TyapkinVI-VI-VI/PSFU-ATmega64/proteus/Безымянный.png

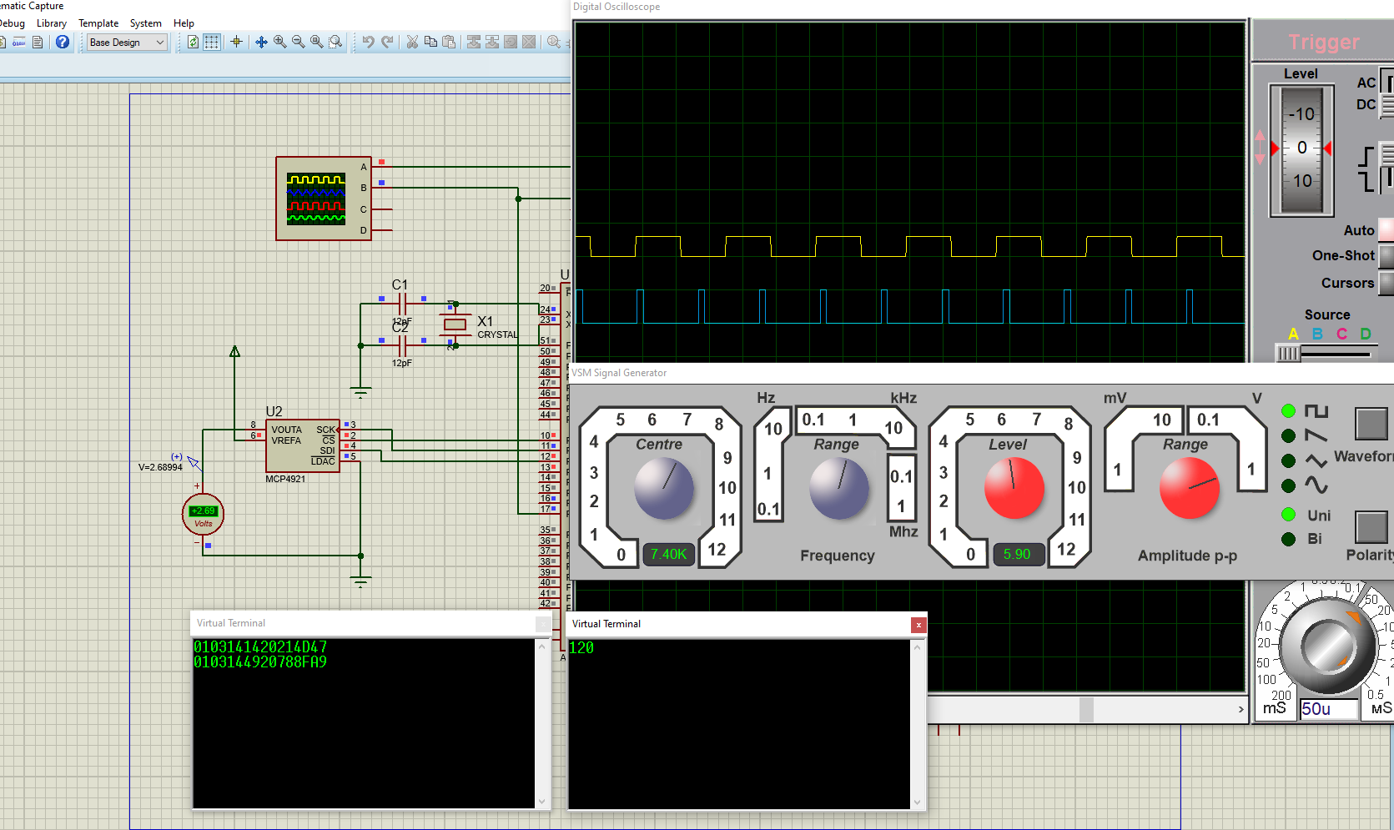
proteus/Безымянный.png
