TyapkinVI-VI-VI/PSFU-ATmega64/proteus/Снимок1.PNG

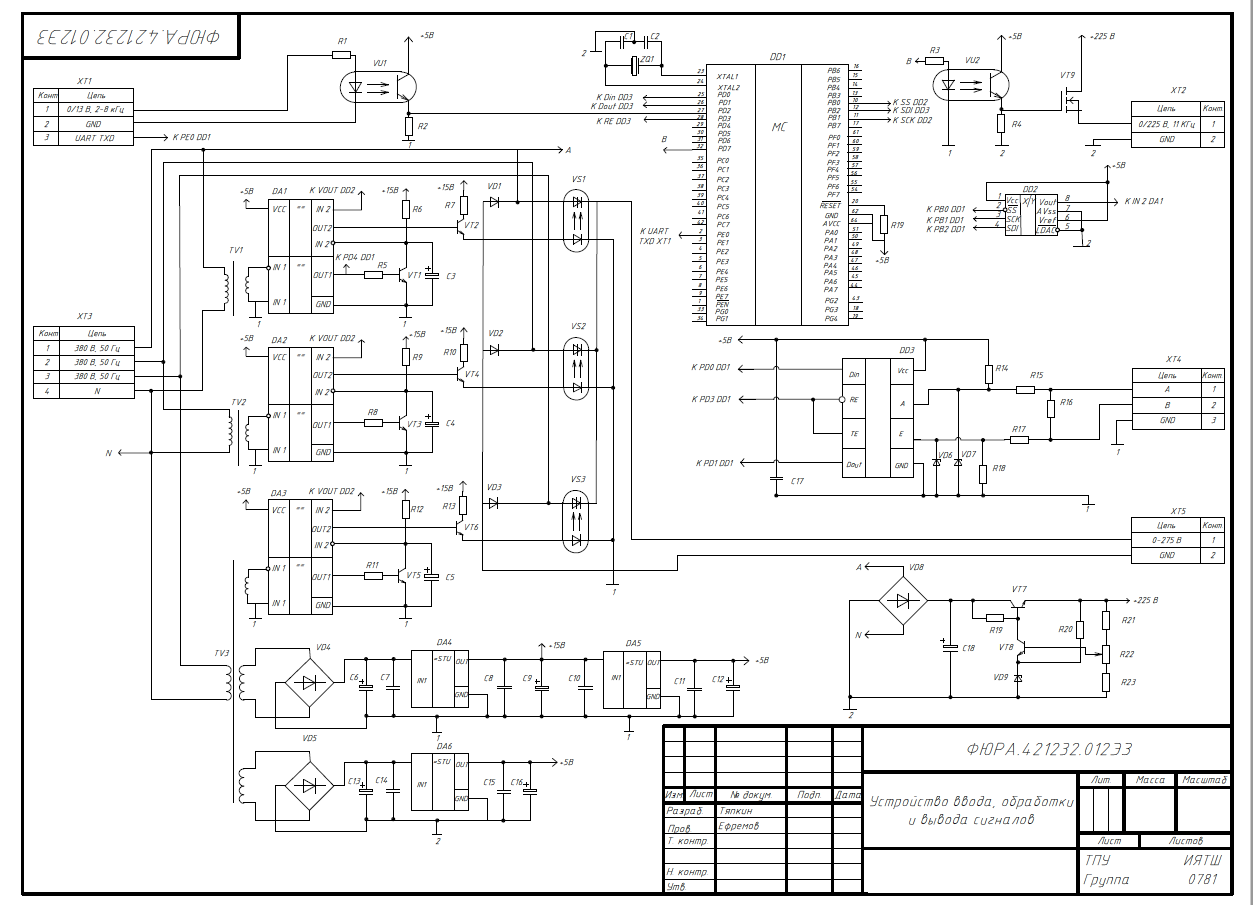
proteus/Снимок1.PNG
