TyapkinVI-VI-VI/PSFU-ATmega64/proteus/Снимок2.PNG

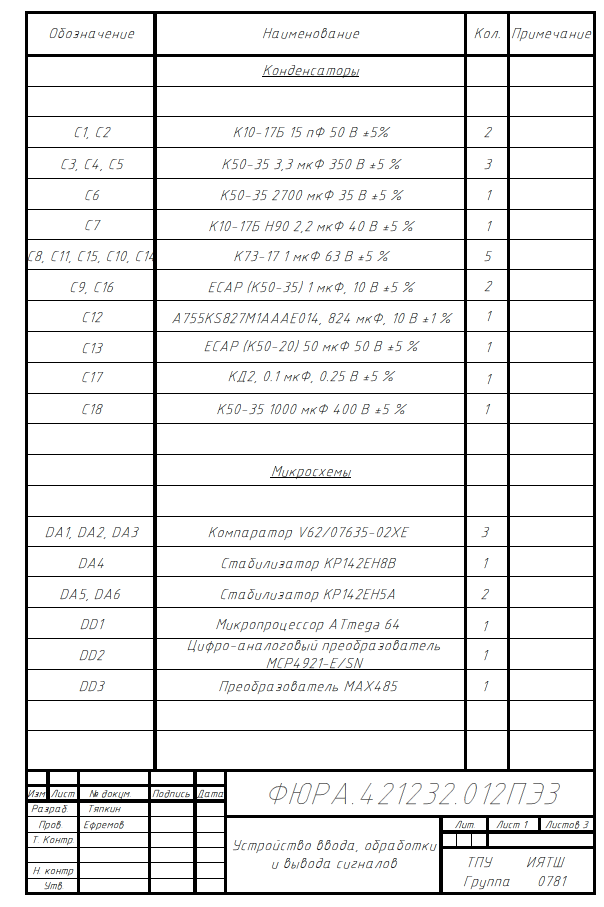
proteus/Снимок2.PNG
