TyapkinVI-VI-VI/PSFU-ATmega64/proteus/Снимок3.PNG

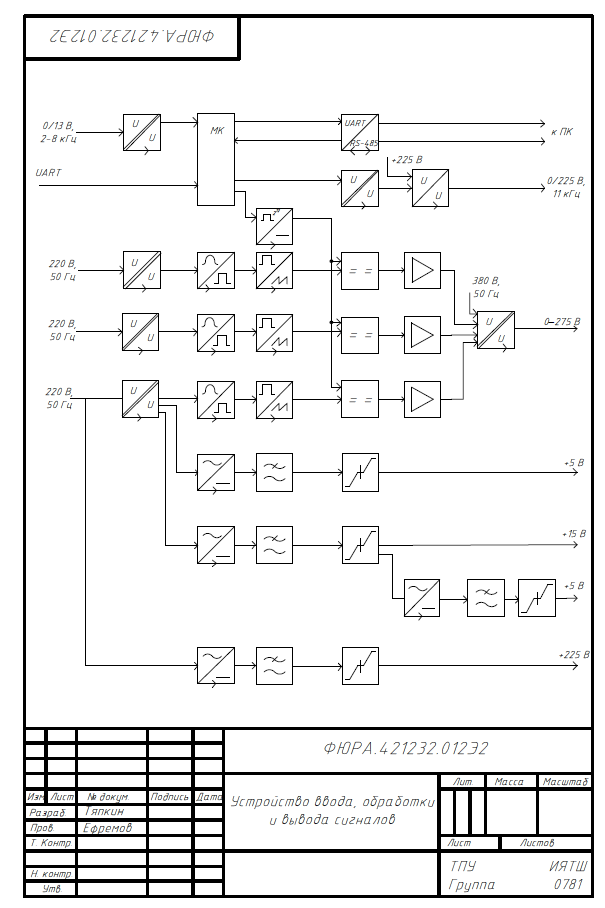
proteus/Снимок3.PNG
