TyapkinVI-VI-VI/PSFU-ATmega64/proteus/Снимок.PNG

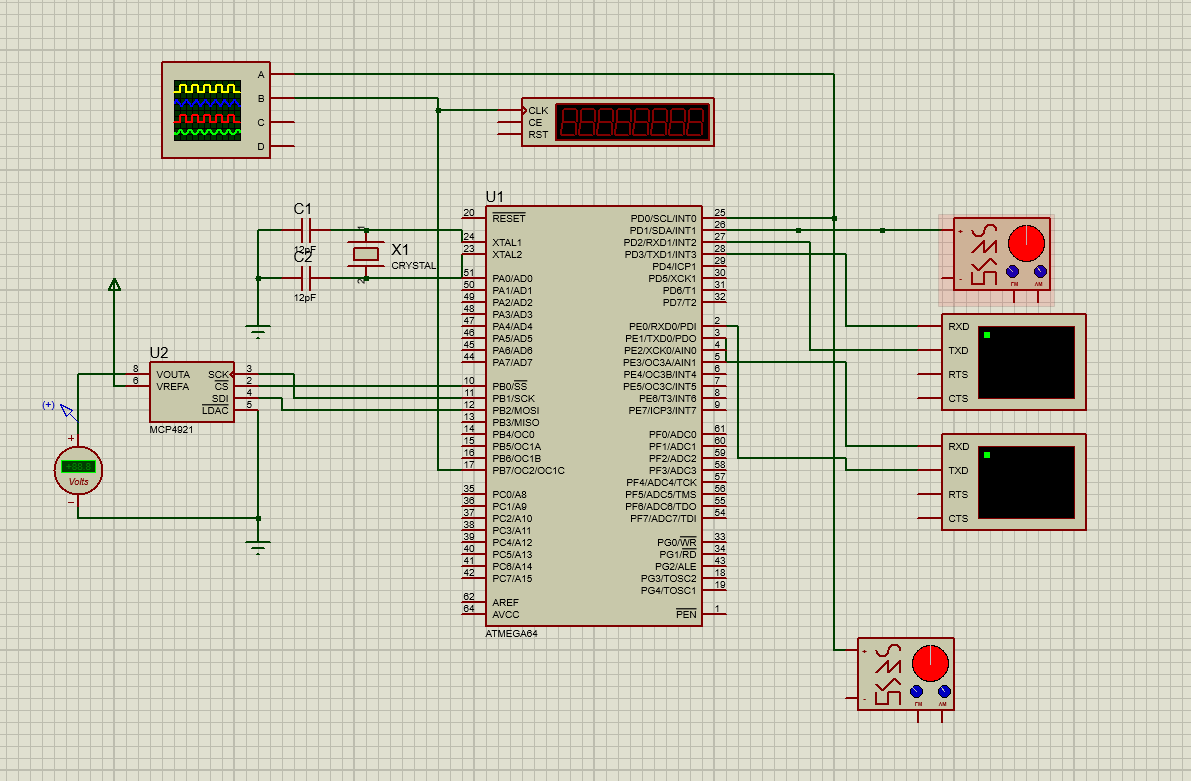
proteus/Снимок.PNG
