TyapkinVI-VI-VI/PSFU-ATmega64/Документация/Функциональная схема(ТяпкинВИ 0781).pdf

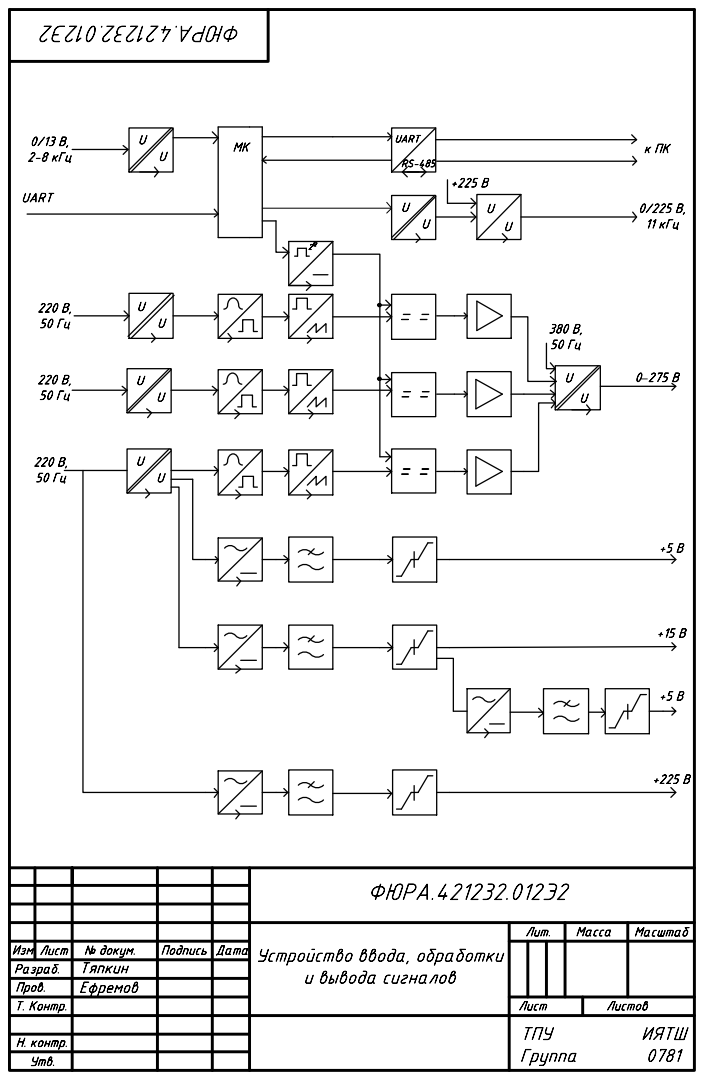
[picture p36: page 1]
0/13 В, 2-8 кГц; UART; 0/225 В, 11 кГц; Лит.; Масса; Масштаб; Лист; Листов; Изм. Лист; № докум.; Подпись; Дата; Разраб. Пров.; Н. контр. Т. Контр.; Утв.; Тяпкин Ефремов; ФЮРА.421232.012Э2; ТПУ; ИЯТШ; Группа

Устройство ввода, обработки
и вывода сигналов
