TyapkinVI-VI-VI/PSFU-ATmega64/Документация/А3 Принципиальная схема(ТяпкинВИ 0781).pdf

MC

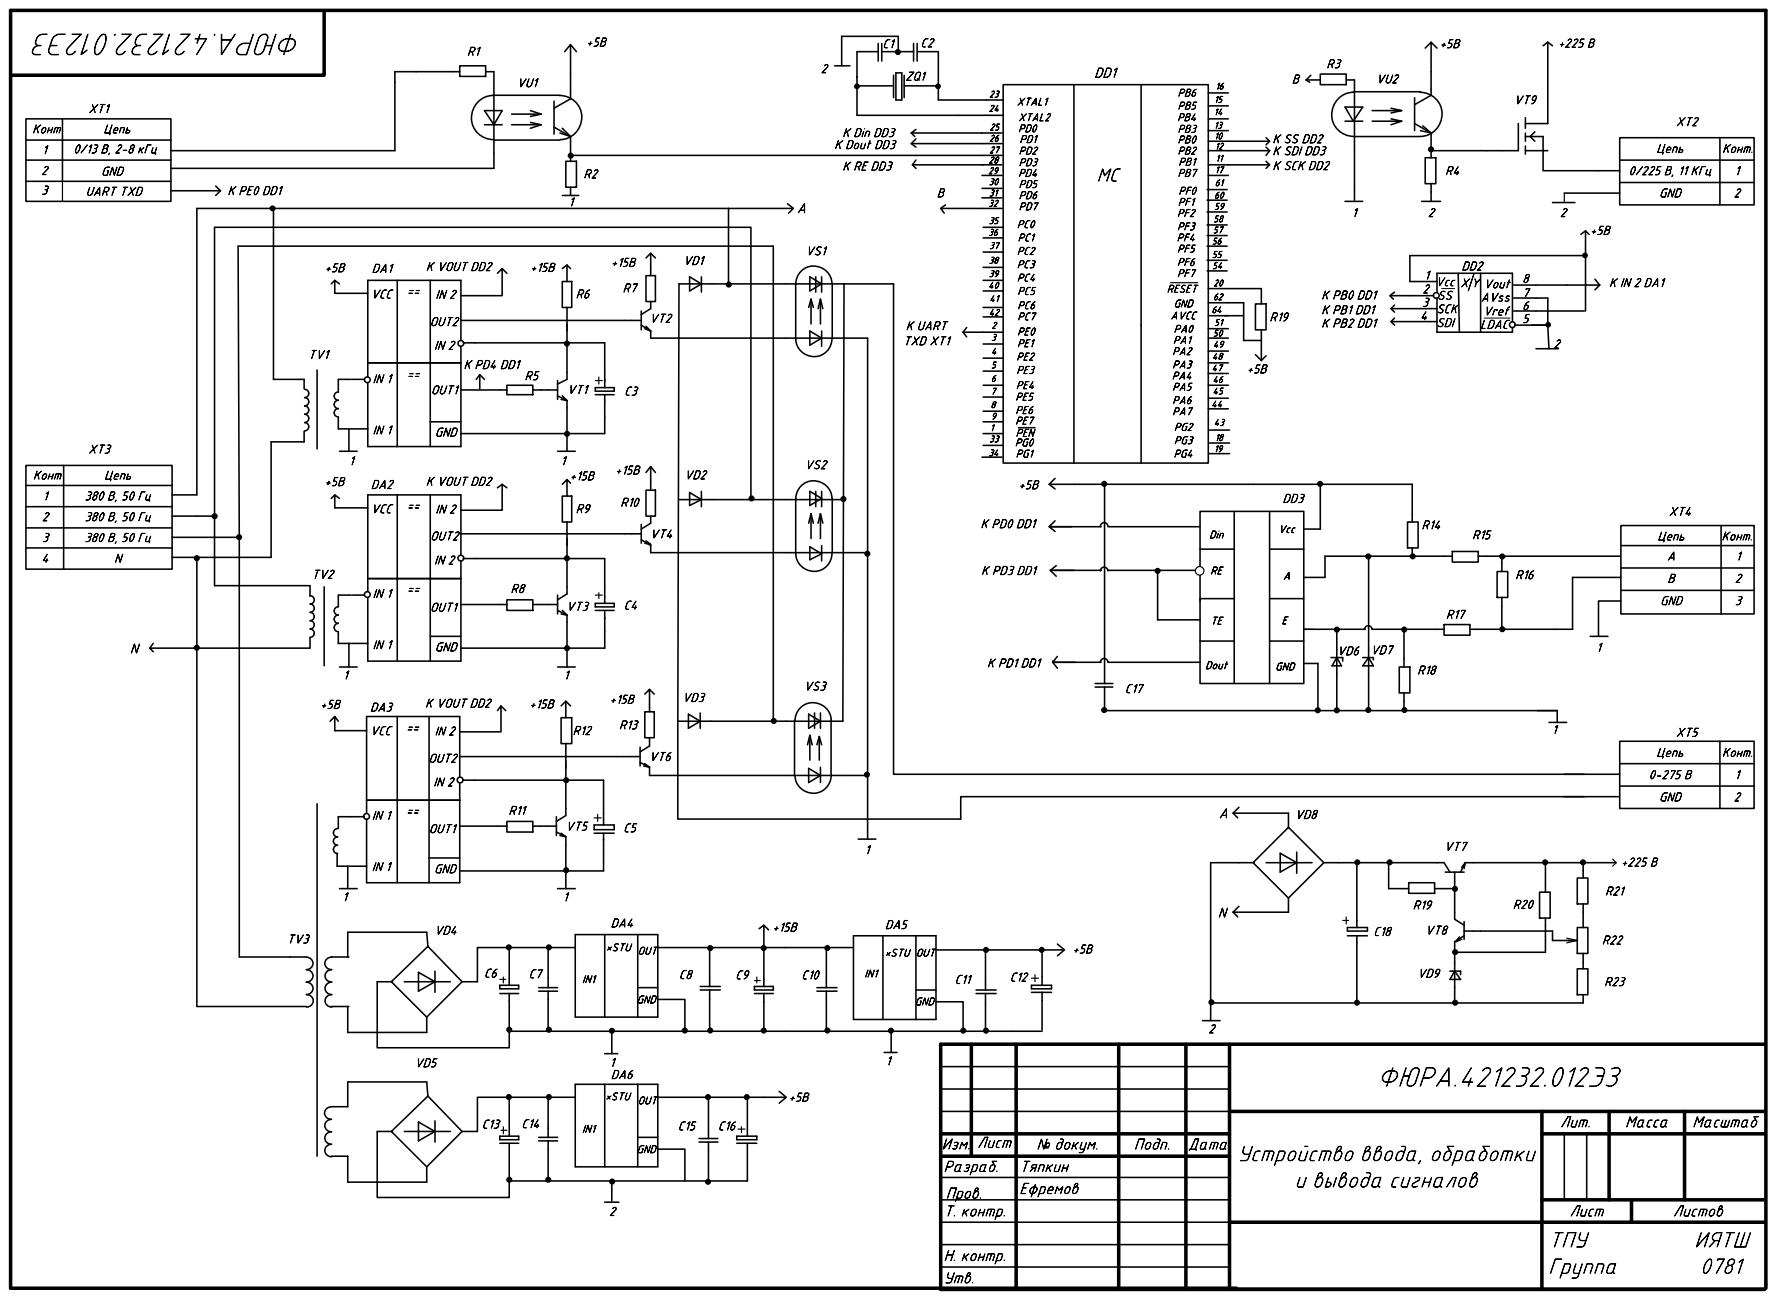
[picture p37: page 1]

VCC | ==

OUT1

== | OUT1

ФЮРА.421232.012ЭЗ

IN1 | *STU | OUT

Устройство ввода, обработки и вывода сигналов | Лит. | Масса | Масштаб

Тяпкин Ефремов

Лист | Листов
ТПУ ИЯТШ Группа 0781

Н. контр. Утв.
