TyapkinVI-VI-VI/PSFU-ATmega64/(list of files, drawings)

Other design files:
proteus/New Project.pdsprj
proteus/схемы/block_na_5v.pdsprj
proteus/схемы/block_na_260V.pdsprj
proteus/схемы/sifu.ms14
